ust-modules/UST5BATT18650V01/README.md

# UST5BATT18650V01 - The 5pcs of 18650 size Li-ion cells holder

The PCB is used as power supply in [SPACEDOS03 spectrometer-dosimeter](https://github.com/UniversalScientificTechnologies/SPACEDOS03).
It could also be used as portable power supply for [LABDOS01](https://github.com/UniversalScientificTechnologies/LABDOS01). The battery holder has 3.3V stabilized output voltage on 3pin JST-GH connector. Charging of cells is provided externally by [precision li-ion charger](https://github.com/MLAB-project/Li-ion-Charger).

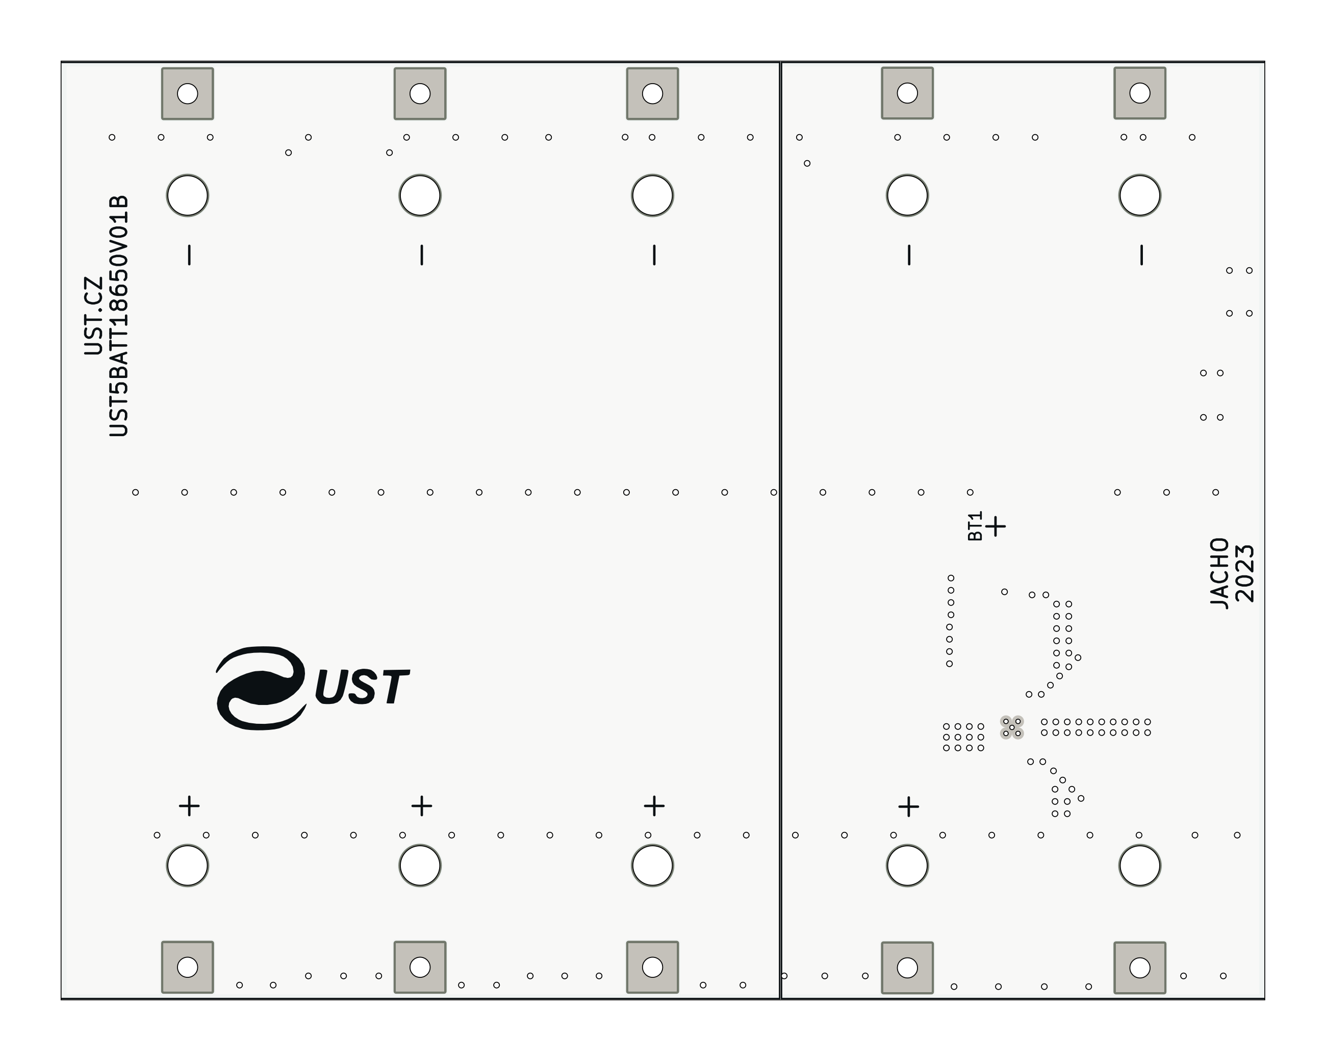
[picture p1: doc/gen/img/UST5BATT18650V01-top.png]
Top view on UST5BATT18650V01

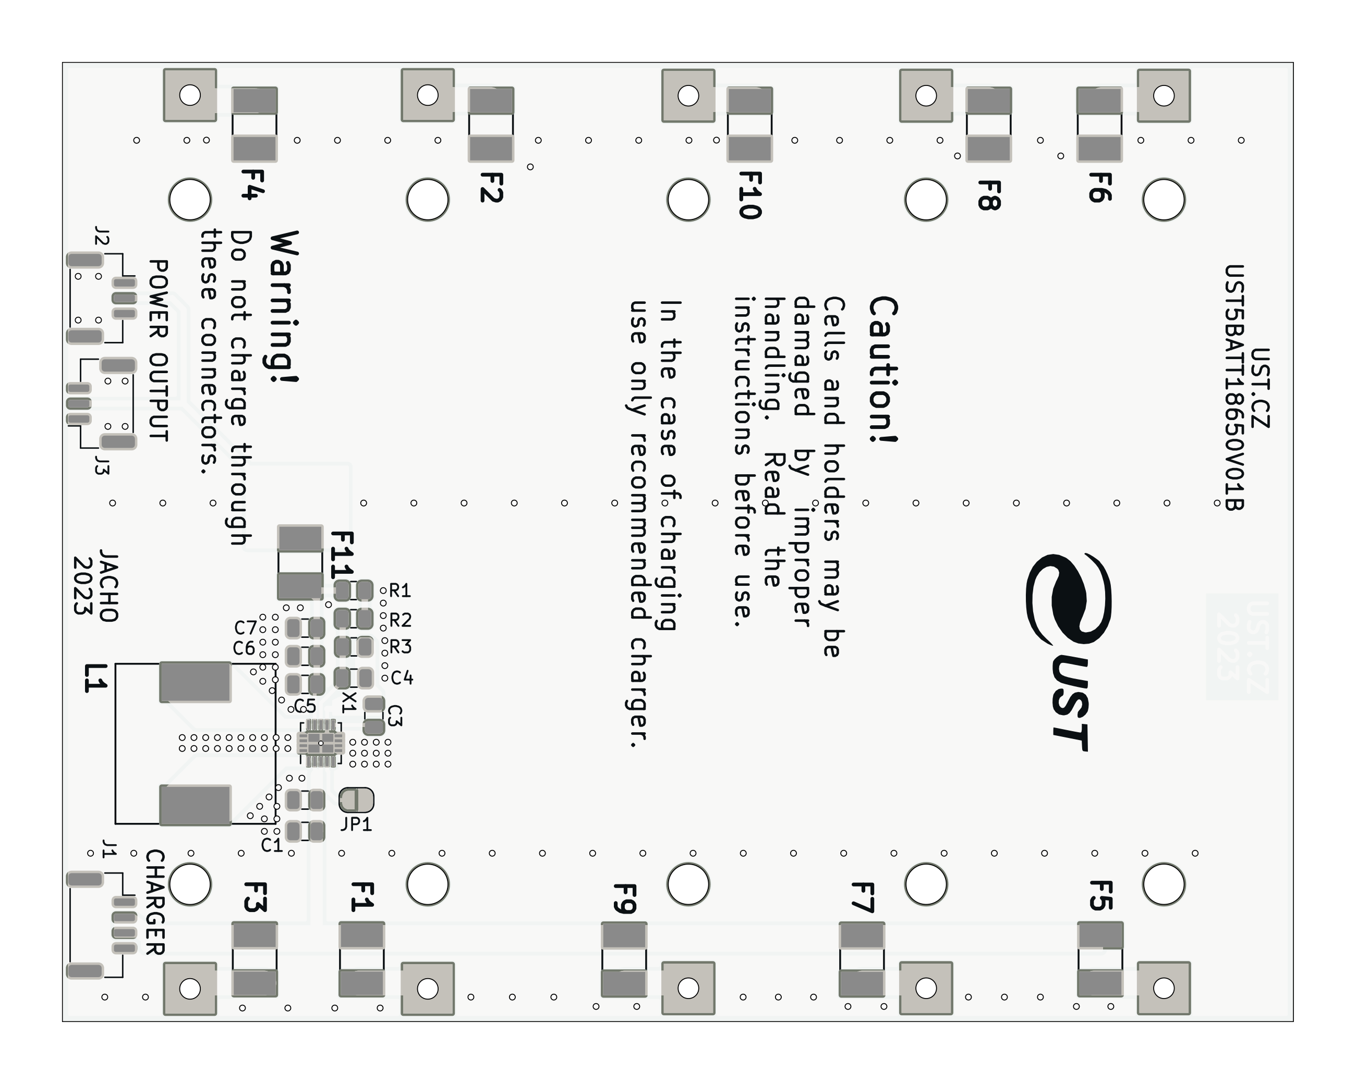
[picture p2: doc/gen/img/UST5BATT18650V01-bottom.png]
Bottom view on UST5BATT18650V01
