ust-modules/UST5BATT18650V01/doc/gen/README.md

# PCB

Board size: 100.0x78.0 mm (3.94x3.07 inches)

- This is the size of the rectangle that contains the board
- Thickness: 1.6 mm (63 mils)
- Material: FR4
- Finish: None
- Layers: 2
- Copper thickness: 35 µm

Solder mask: TOP / BOTTOM

- Color: Green

Silk screen: TOP / BOTTOM

- Color: White

Stackup:

| Name | Type | Color | Thickness | Material | Epsilon_r | Loss tangent |
|---|---|---|---|---|---|---|
| F.SilkS | Top Silk Screen | | | | | |
| F.Paste | Top Solder Paste | | | | | |
| F.Mask | Top Solder Mask | Green | 10 | | | |
| F.Cu | copper | | 35 | | | |
| dielectric 1 | core | | 1510 | FR4 | 4.5 | 0.020 |
| B.Cu | copper | | 35 | | | |
| B.Mask | Bottom Solder Mask | Green | 10 | | | |
| B.Paste | Bottom Solder Paste  | | | | | |
| B.SilkS | Bottom Silk Screen | | | | | |

# Important sizes

Clearance: 0.2 mm (8 mils)

Track width: 0.3 mm (12 mils)

- By design rules: 0.2 mm (8 mils)

Drill: 0.4 mm (16 mils)

- Vias: 0.5 mm (20 mils) [Design: 0.4 mm (16 mils)]
- Pads: 0.4 mm (16 mils)
- The above values are real drill sizes, they add 0.1 mm (4 mils) to plated holes (PTH)

Via: 0.8/0.4 mm (31/16 mils)

- By design rules: 0.4/0.3 mm (16/12 mils)
- Micro via: no [0.2/0.1 mm (8/4 mils)]
- Buried/blind via: no
- Total: 167 (thru: 167 buried/blind: 0 micro: 0)

Outer Annular Ring: 0.1 mm (4 mils)

- By design rules: 0.1 mm (4 mils)

Eurocircuits class: 6C
- Using min drill 0.35 mm for an OAR of 0.13 mm

# General stats

Components count: (SMD/THT)

- Top: 0/3 (THT)
- Bottom: 25/2 (SMD + THT)

Defined tracks:

- 0.2 mm (8 mils)
- 0.3 mm (12 mils)
- 0.4 mm (16 mils)
- 0.5 mm (20 mils)
- 0.6 mm (24 mils)
- 0.8 mm (31 mils)
- 1.0 mm (39 mils)

Used tracks:

- 0.3 mm (12 mils) (37) defined: yes
- 0.5 mm (20 mils) (22) defined: yes
- 1.0 mm (39 mils) (17) defined: yes
- 2.0 mm (79 mils) (10) defined: no

Defined vias:

- 0.8/0.4 mm (31/16 mils)

Used vias:

- 0.8/0.4 mm (31/16 mils) (Count: 167, Aspect: 2.0 A) defined: yes

Holes (excluding vias):

- 0.3 mm (12 mils) (5)
- 1.6 mm (63 mils) (10)
- 3.2 mm (126 mils) (10)

Oval holes:

Drill tools (including vias and computing adjusts and rounding):

- 0.4 mm (16 mils) (5)
- 0.5 mm (20 mils) (167)
- 1.7 mm (67 mils) (10)
- 3.2 mm (126 mils) (10)
