ust-modules/UST5BATT18650V01/doc/img/UST5BATT18650V01_render1.png

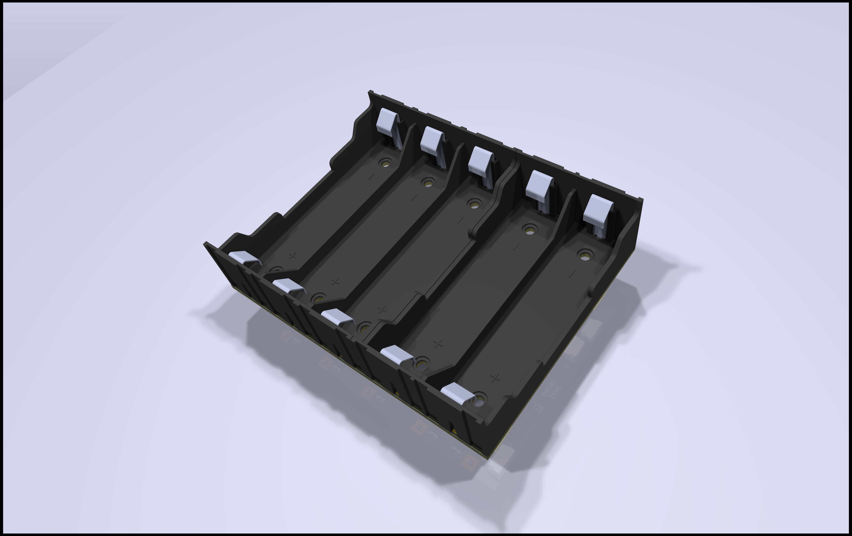
doc/img/UST5BATT18650V01_render1.png
