ust-modules/UST5BATT18650V01/doc/img/UST5BATT18650V01A_top.png

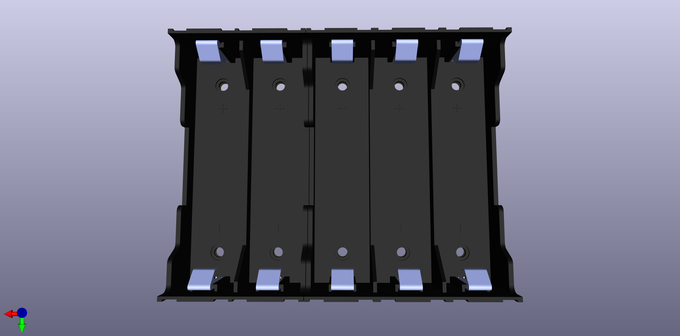
doc/img/UST5BATT18650V01A_top.png
