ust-modules/UST5BATT18650V01/doc/gen/dxf/UST5BATT18650V01-B_Cu.dxf

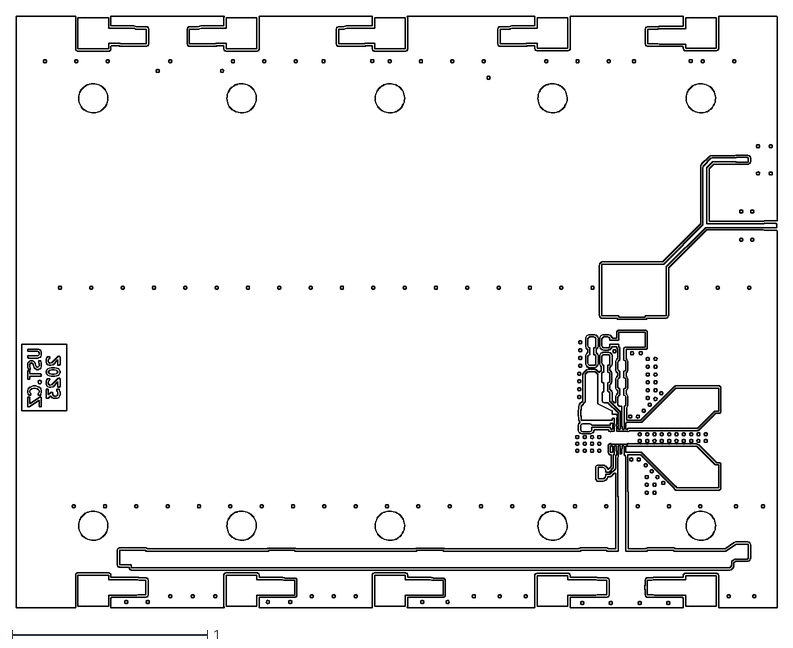
[picture p7: CAD file, 2023-03-28]
doc/gen/dxf/UST5BATT18650V01-B_Cu.dxf
3.90 x 3.03
