ust-modules/UST5BATT18650V01/doc/gen/UST5BATT18650V01.step

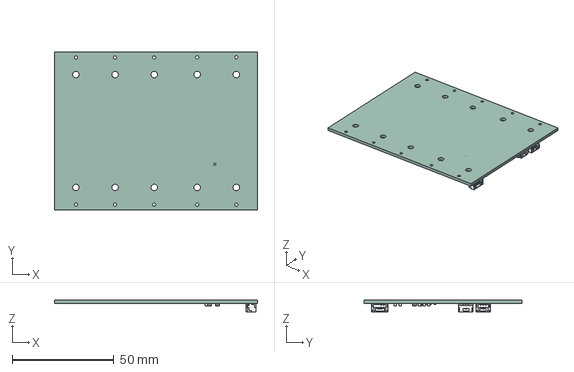
[picture p8: CAD file, 2024-03-28]
doc/gen/UST5BATT18650V01.step
100.0 x 78.0 x 5.89 mm
tmp0t0wy77o PCB
