ust-modules/UST5BATT18650V01/doc/gen/dxf/UST5BATT18650V01-F_Fab.dxf

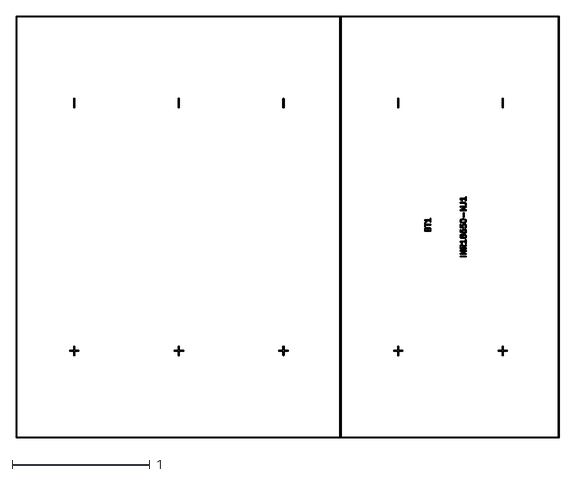
[picture p10: CAD file, 2023-03-28]
doc/gen/dxf/UST5BATT18650V01-F_Fab.dxf
3.94 x 3.06
