ust-modules/UST5BATT18650V01/doc/gen/dxf/UST5BATT18650V01-B_Courtyard.dxf

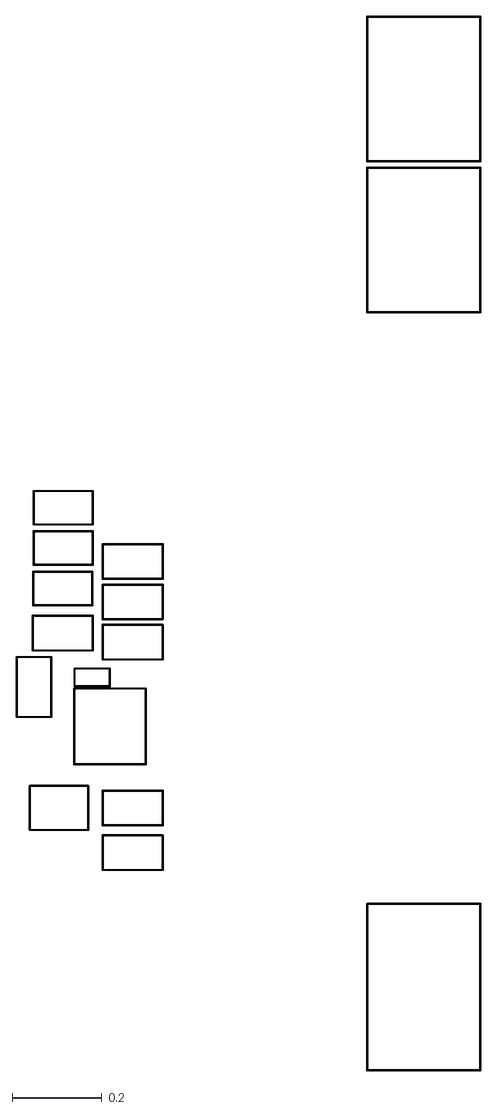
[picture p11: CAD file, 2023-03-28]
doc/gen/dxf/UST5BATT18650V01-B_Courtyard.dxf
1.04 x 2.35
