ust-modules/UST5BATT18650V01/doc/gen/dxf/UST5BATT18650V01-B_Fab.dxf

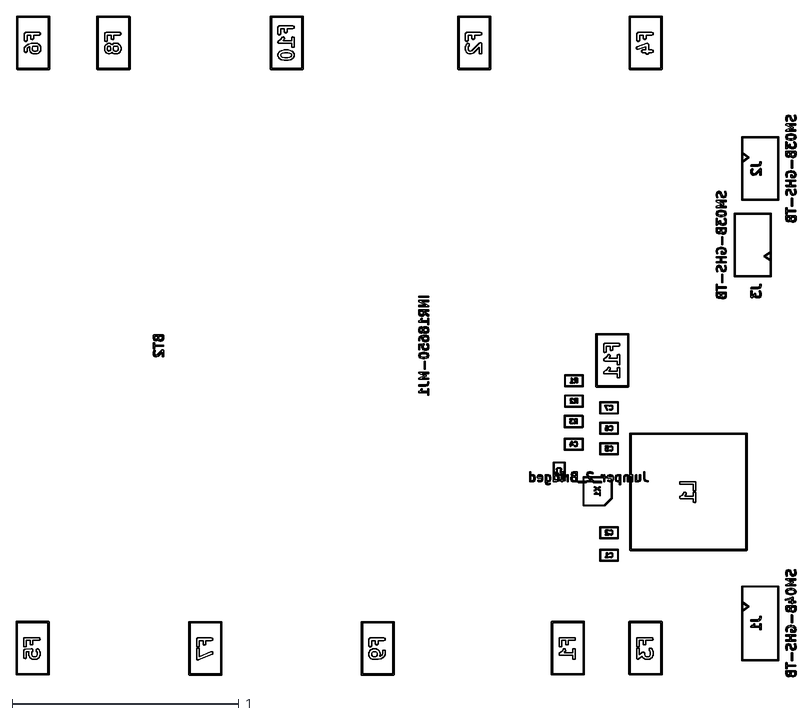
[picture p12: CAD file, 2023-03-28]
doc/gen/dxf/UST5BATT18650V01-B_Fab.dxf
3.44 x 2.91
