ust-modules/UST5BATT18650V01/doc/gen/dxf/UST5BATT18650V01A-B_Cu.dxf

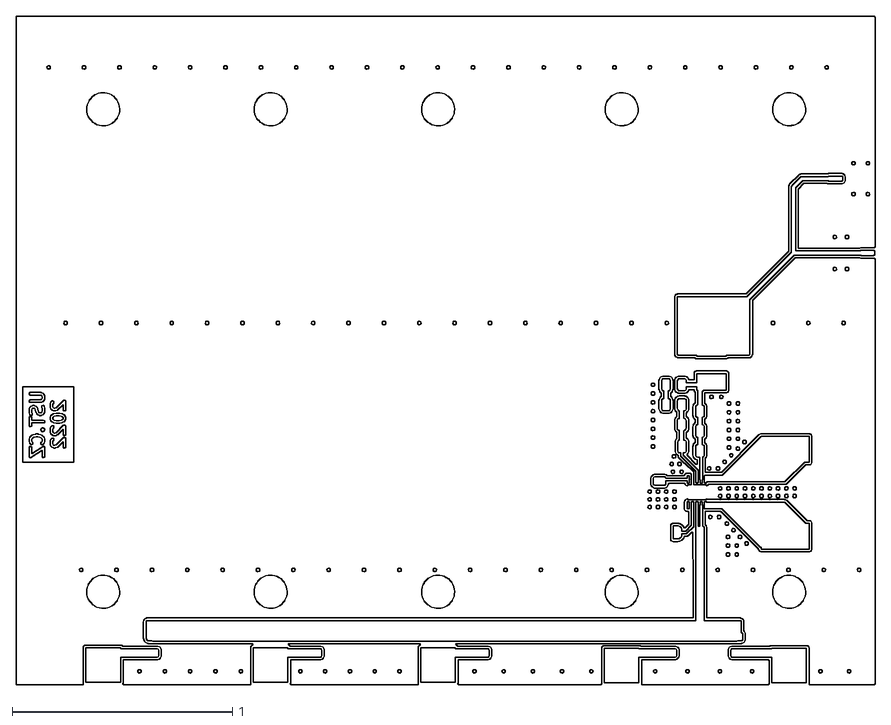
[picture p13: CAD file, 2022-10-18]
doc/gen/dxf/UST5BATT18650V01A-B_Cu.dxf
3.90 x 3.03
