ust-modules/UST5BATT18650V01/doc/gen/dxf/UST5BATT18650V01A-B_Courtyard.dxf

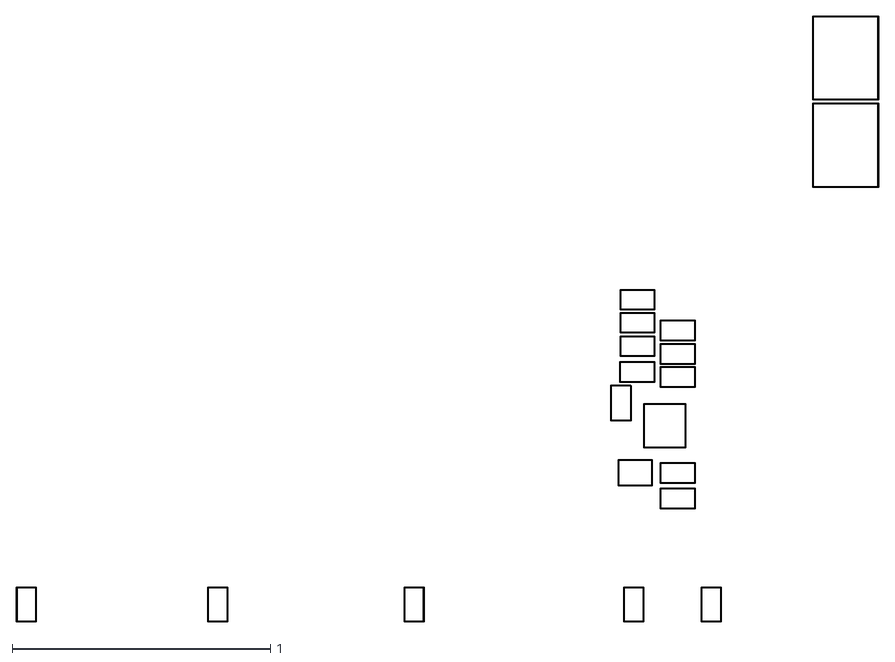
[picture p15: CAD file, 2022-10-16]
doc/gen/dxf/UST5BATT18650V01A-B_Courtyard.dxf
3.34 x 2.34
