ust-modules/UST5BATT18650V01/doc/gen/dxf/UST5BATT18650V01-Edge_Cuts.dxf

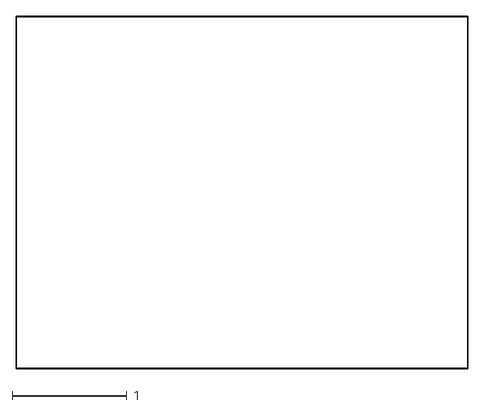
[picture p16: CAD file, 2022-10-16]
doc/gen/dxf/UST5BATT18650V01-Edge_Cuts.dxf
3.94 x 3.07
