ust-modules/UST5BATT18650V01/doc/gen/dxf/UST5BATT18650V01-F_Courtyard.dxf

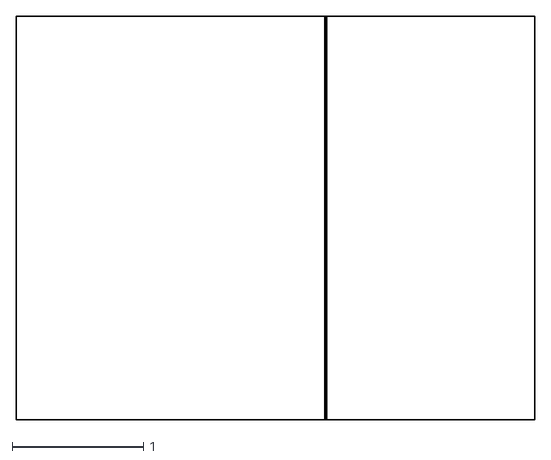
[picture p17: CAD file, 2022-10-16]
doc/gen/dxf/UST5BATT18650V01-F_Courtyard.dxf
3.96 x 3.08
