ust-modules/UST5BATT18650V01/(list of files, cad)

Other CAD files:
doc/gen/dxf/UST5BATT18650V01-User_Eco2.dxf
doc/gen/dxf/UST5BATT18650V01-Margin.dxf
doc/gen/dxf/UST5BATT18650V01-User_Drawings.dxf
doc/gen/dxf/UST5BATT18650V01-F_Adhesive.dxf
doc/gen/dxf/UST5BATT18650V01-User_Eco1.dxf
doc/gen/dxf/UST5BATT18650V01-B_Adhesive.dxf
doc/gen/dxf/UST5BATT18650V01-User_Comments.dxf
doc/gen/dxf/UST5BATT18650V01-B_Mask.dxf
doc/gen/dxf/UST5BATT18650V01-B_Paste.dxf
doc/gen/dxf/UST5BATT18650V01-B_Silkscreen.dxf
doc/gen/dxf/UST5BATT18650V01-F_Mask.dxf
doc/gen/dxf/UST5BATT18650V01-F_Paste.dxf
doc/gen/dxf/UST5BATT18650V01-F_Silkscreen.dxf
doc/gen/dxf/UST5BATT18650V01A-B_Paste.dxf
doc/gen/dxf/UST5BATT18650V01A-F_Silkscreen.dxf
