ust-modules/UST5BATT18650V01/doc/gen/UST5BATT18650V01-schematic.pdf

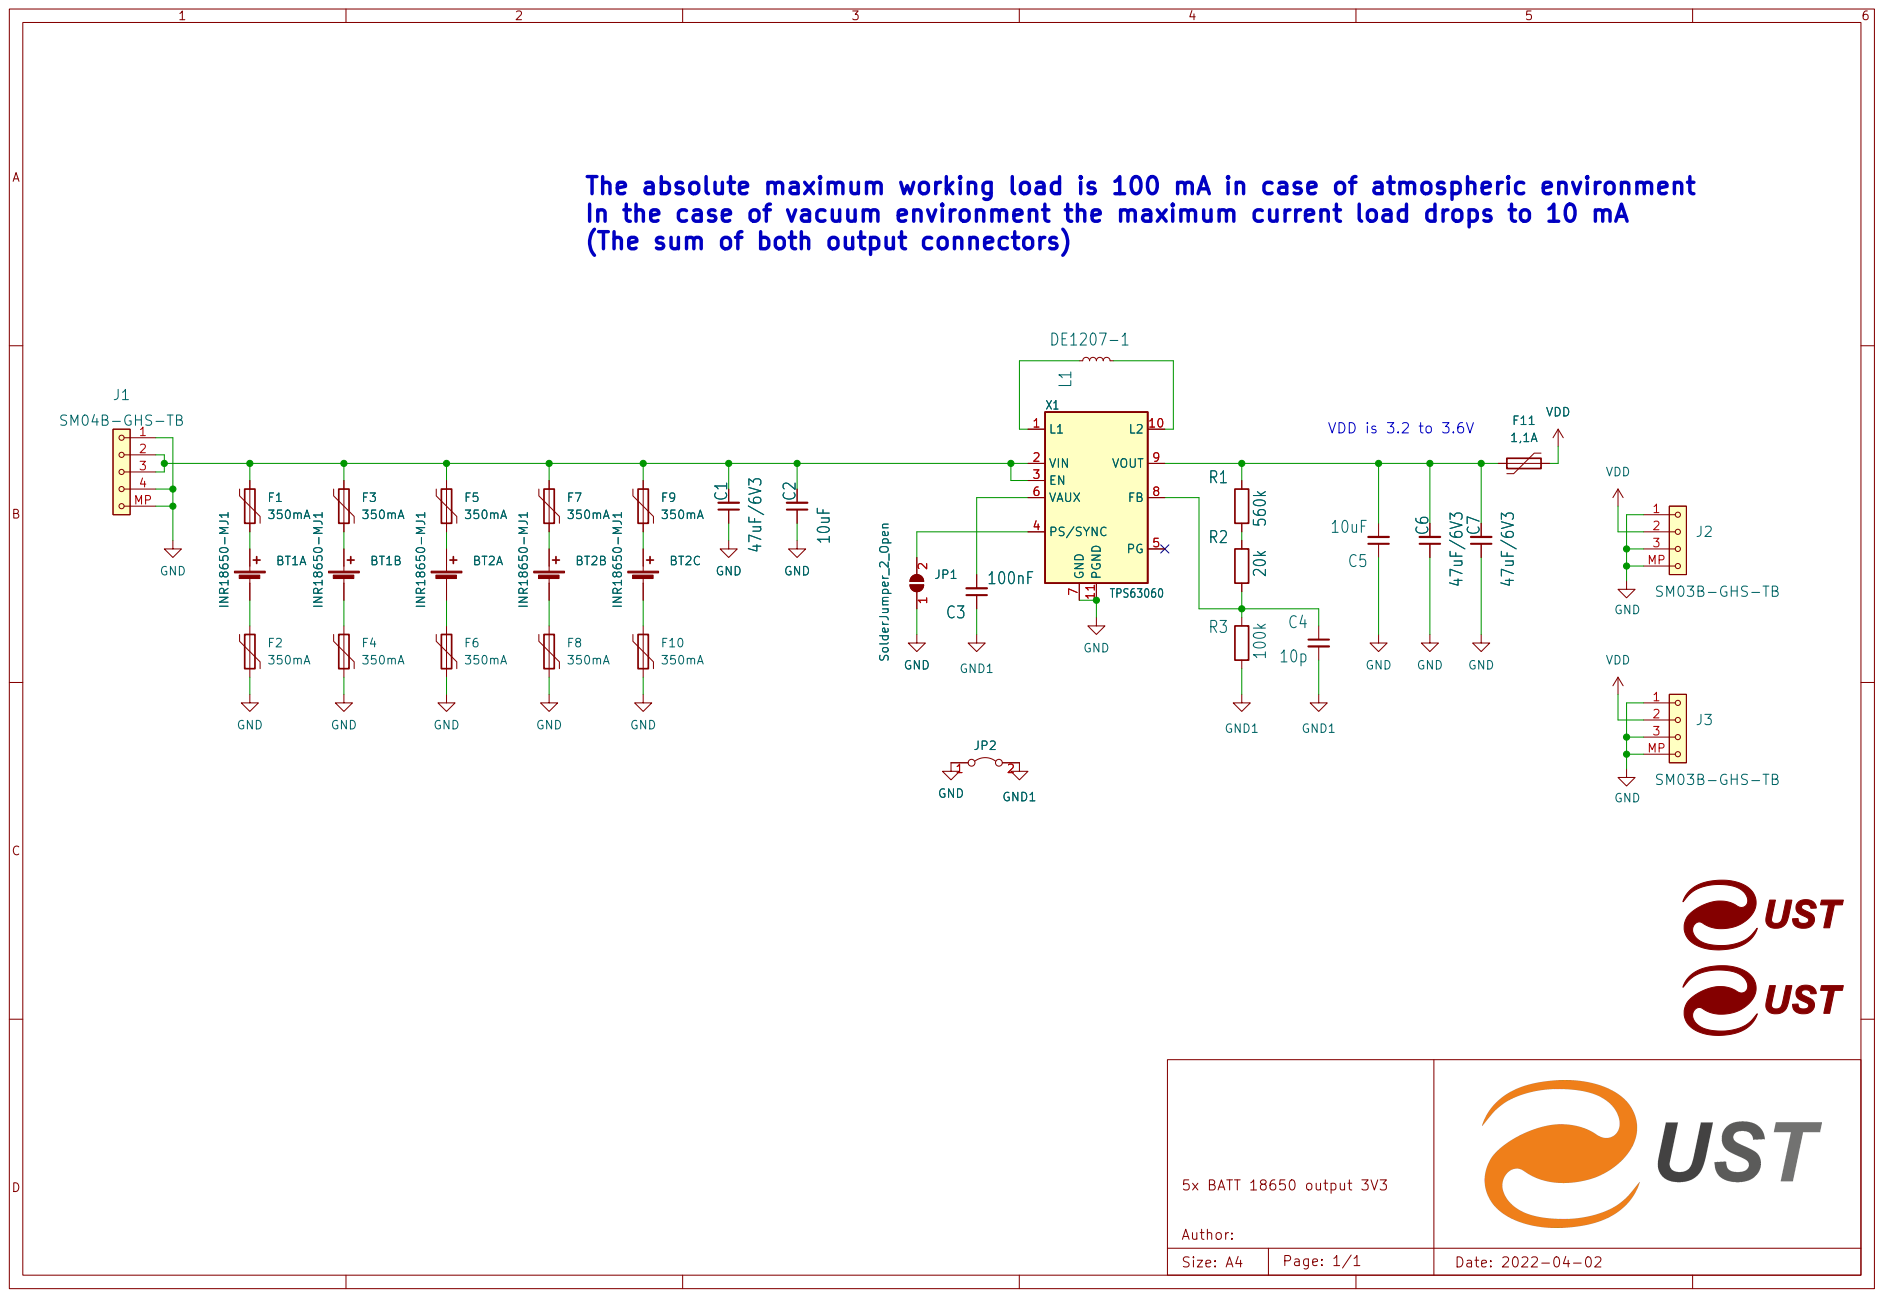
[picture p18: page 1]
