ust-modules/UST5BATT18650V01/doc/drawing.pdf

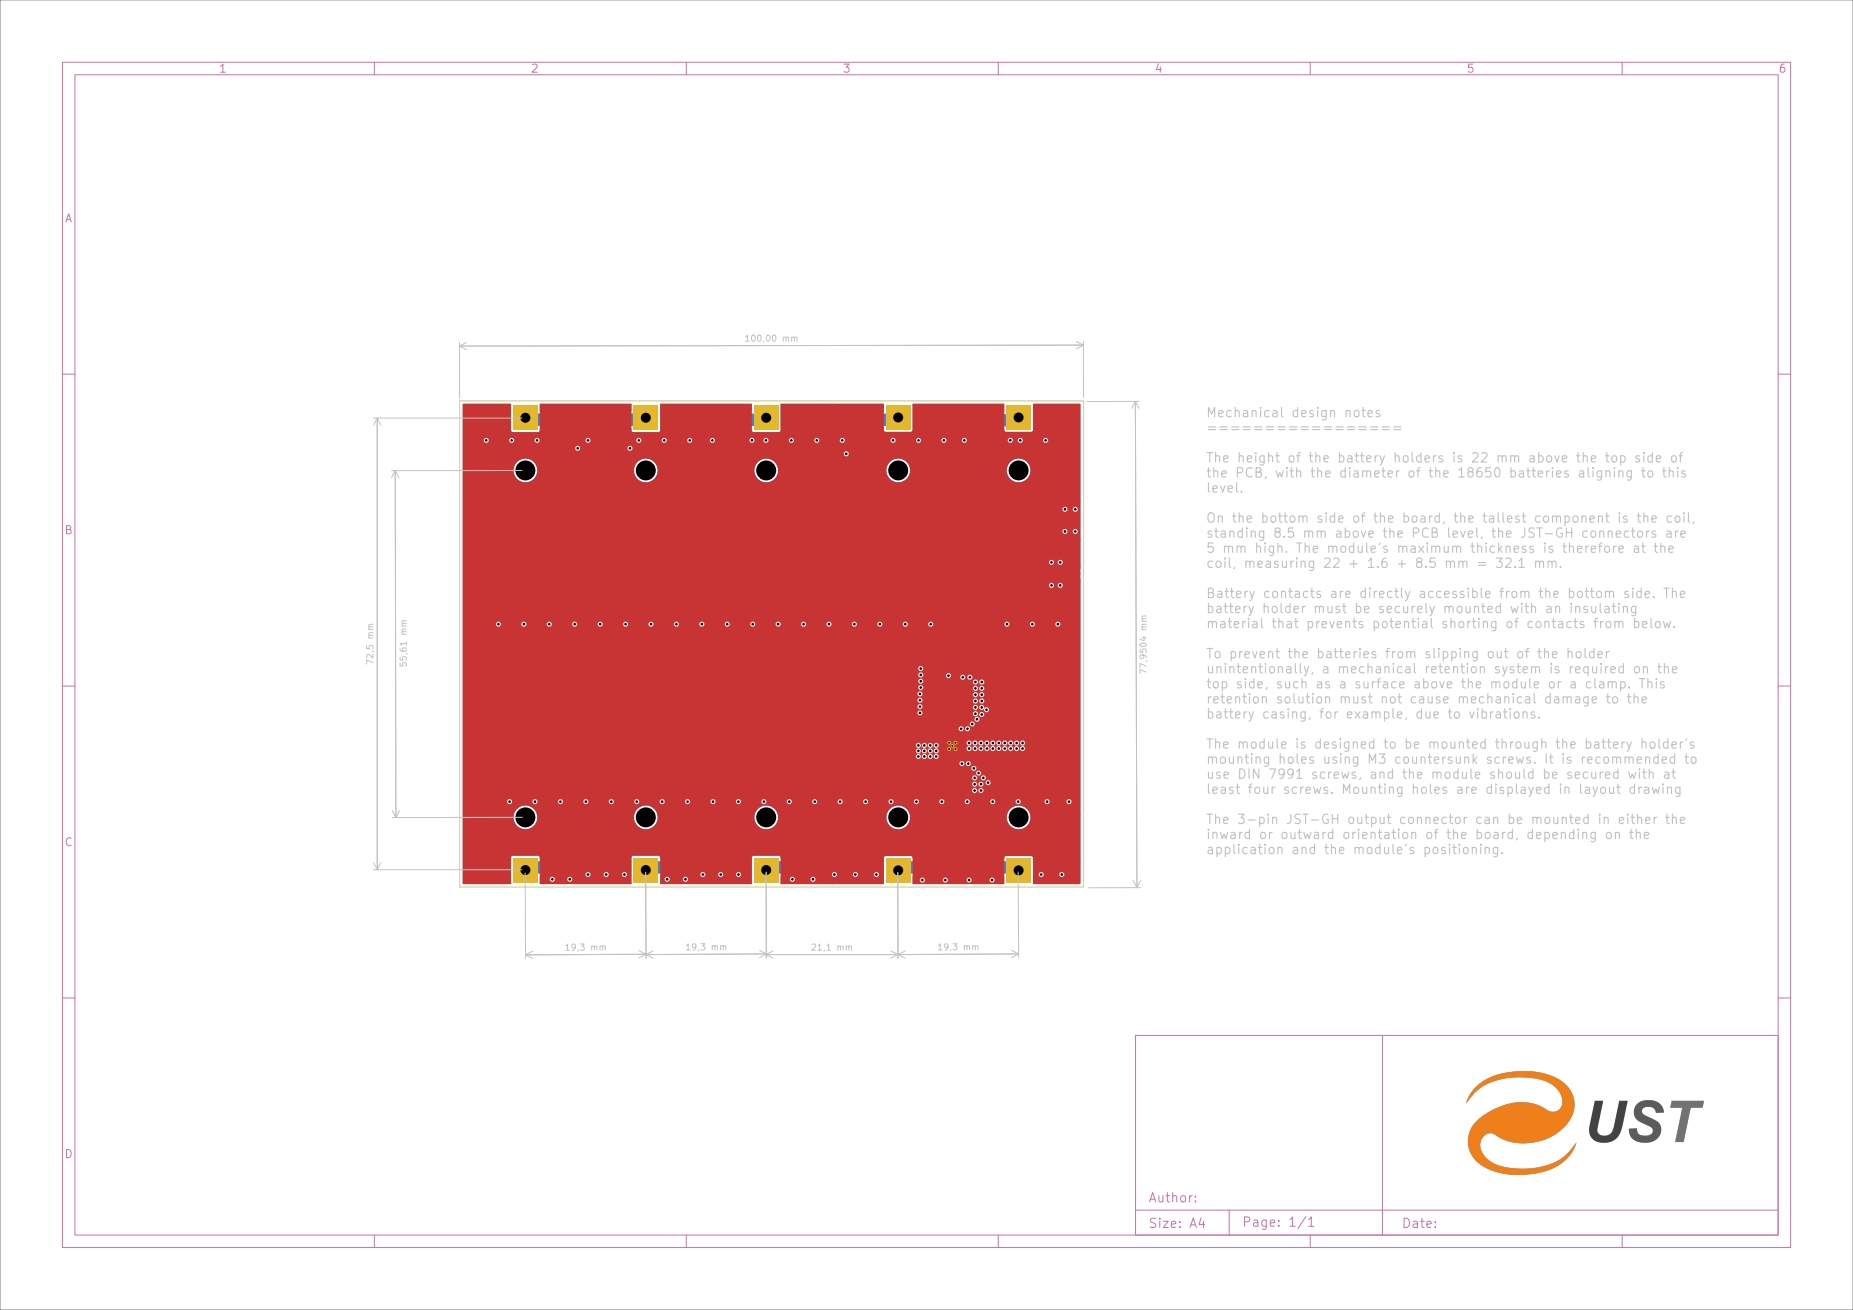
[picture p19: page 1]
