ust-modules/UST5BATT18650V01/hw/cam_profi/docs/UST5BATT18650V01B-B_Fab+Edge_Cuts.pdf

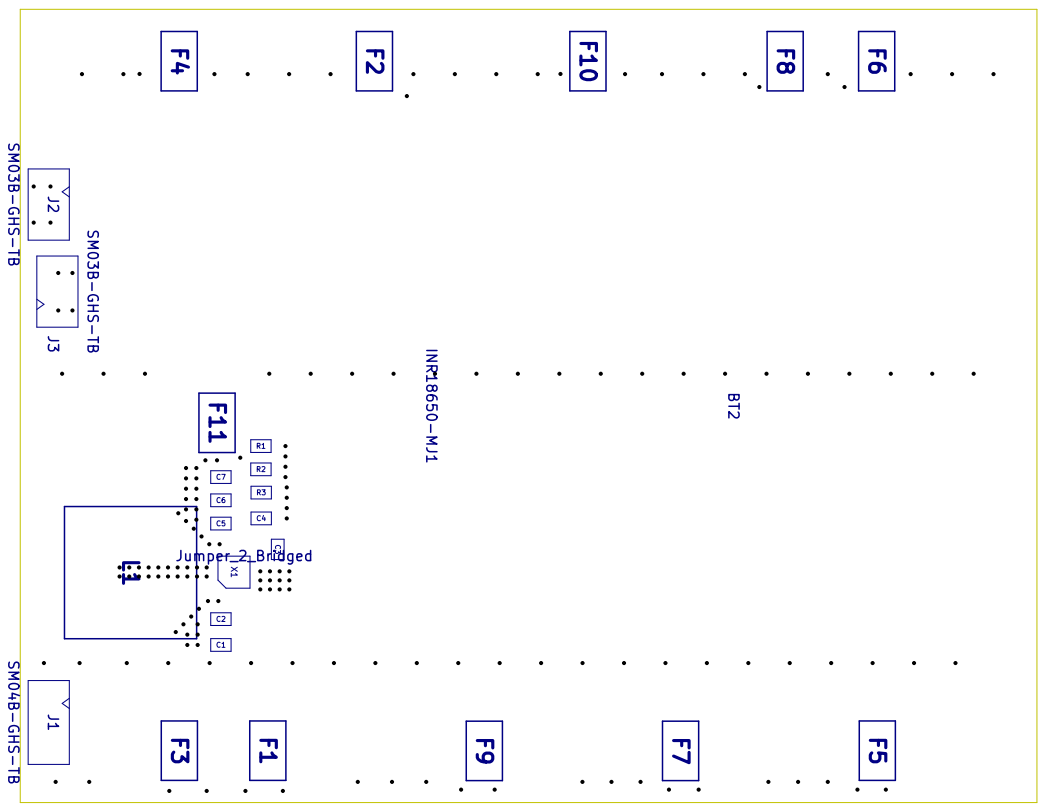
[picture p20: page 1]
