ust-modules/UST5BATT18650V01/hw/cam_profi/docs/UST5BATT18650V01B-F_Fab+Edge_Cuts.pdf

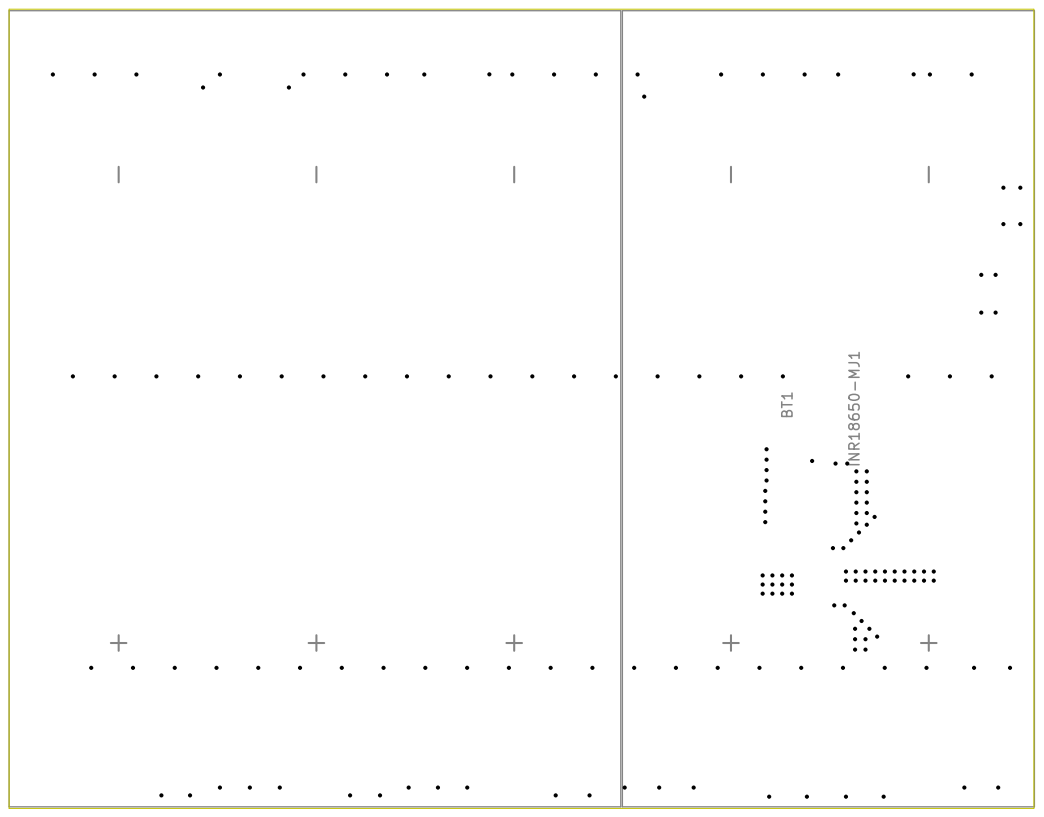
[picture p21: page 1]
