ust-modules/UST5BATT18650V01/(commit log)

2022-10-13 Editing schema
    [UST5BATT18650V01A.kicad_pcb, UST5BATT18650V01A.kicad_sch]
2022-10-14 Edit schema
    [UST5BATT18650V01A.kicad_sch]
2022-10-15 Edit schema and PCB
    [UST5BATT18650V01A.kicad_pcb, UST5BATT18650V01A.kicad_sch]
2022-10-15 Edit PCB
    [UST5BATT18650V01A.kicad_pcb]
2022-10-16 Add kicad_outputs.yml
2022-10-16 Edit kicad_outputs.yml
2022-10-16 Update actions products
    [UST5BATT18650V01A-B_Adhesive.dxf, UST5BATT18650V01A-B_Courtyard.dxf, UST5BATT18650V01A-B_Cu.dxf, UST5BATT18650V01A-B_Fab.dxf, UST5BATT18650V01A-B_Mask.dxf, UST5BATT18650V01A-B_Paste.dxf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]
2022-10-16 Edit PCB and schema
    [UST5BATT18650V01A.kicad_pcb, UST5BATT18650V01A.kicad_sch]
2022-10-24 Edit UST_ID and B.FAB
    [UST5BATT18650V01A.kicad_pcb, UST5BATT18650V01A.kicad_sch]
2023-01-18 PCB 3D model generation
2023-02-17 Update documentation Add note about the supposed output load current.
    [UST5BATT18650V01A.kicad_sch]
2023-02-17 Improve note.
    [UST5BATT18650V01A.kicad_sch]
2023-03-25 Prechod na B
    [USB5BATT18650V01B.kicad_pcb, USB5BATT18650V01B.kicad_sch]
2023-03-25 Adding fuses to the schematic
    [USB5BATT18650V01B.kicad_pcb, USB5BATT18650V01B.kicad_sch]
2023-03-25 Update kicad_outputs.yml
    Rename
2023-03-28 Uprava silkscreanu, layoutu
    [USB5BATT18650V01B.kicad_pcb]
2023-03-28 uprava schematu - propojka GND, GND1
    [USB5BATT18650V01B.kicad_pcb, USB5BATT18650V01B.kicad_sch]
2023-03-28 rename bad name
    [UST5BATT18650V01B.kicad_pcb, UST5BATT18650V01B.kicad_sch]
2023-03-28 rename to new convention
    [UST5BATT1865001.kicad_pcb, UST5BATT1865001.kicad_sch]
2023-03-28 Improve silkscreen and readme.
    [UST5BATT18650V01.kicad_pcb]
2023-03-28 Add datasheet to switching regulator.
2024-10-30 add more verbose description of mounting methods, add dimensions of PCB into drawing layer
    [UST5BATT18650V01.kicad_pcb]
